austin-lew/Battery_Protector_AN_Hardware/rev1/testing/mosfet_test_b.jpg

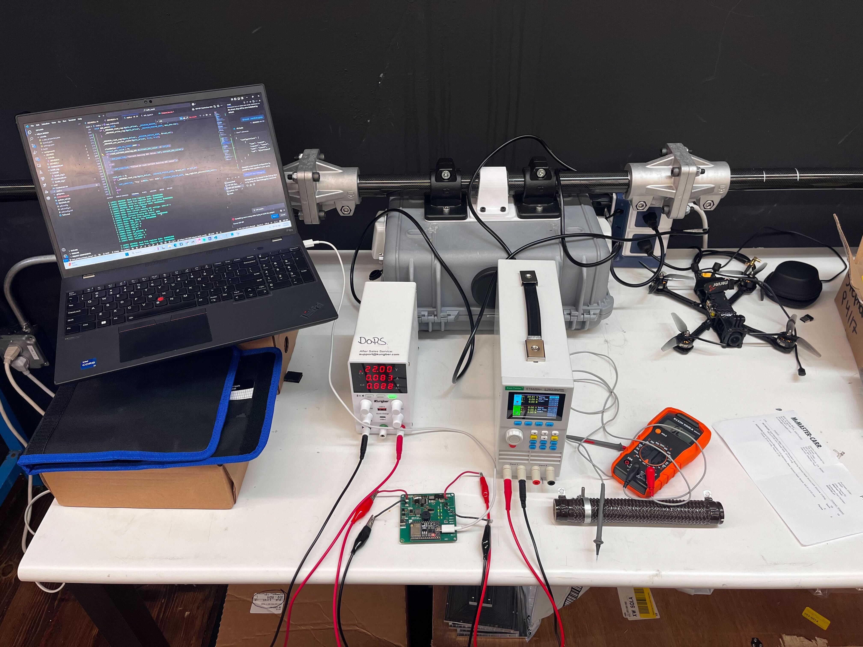
rev1/testing/mosfet_test_b.jpg
