austin-lew/Battery_Protector_AN_Hardware/battery_protector.kicad_pcb

## KiCad design battery_protector.kicad_pcb (2025-08-19)

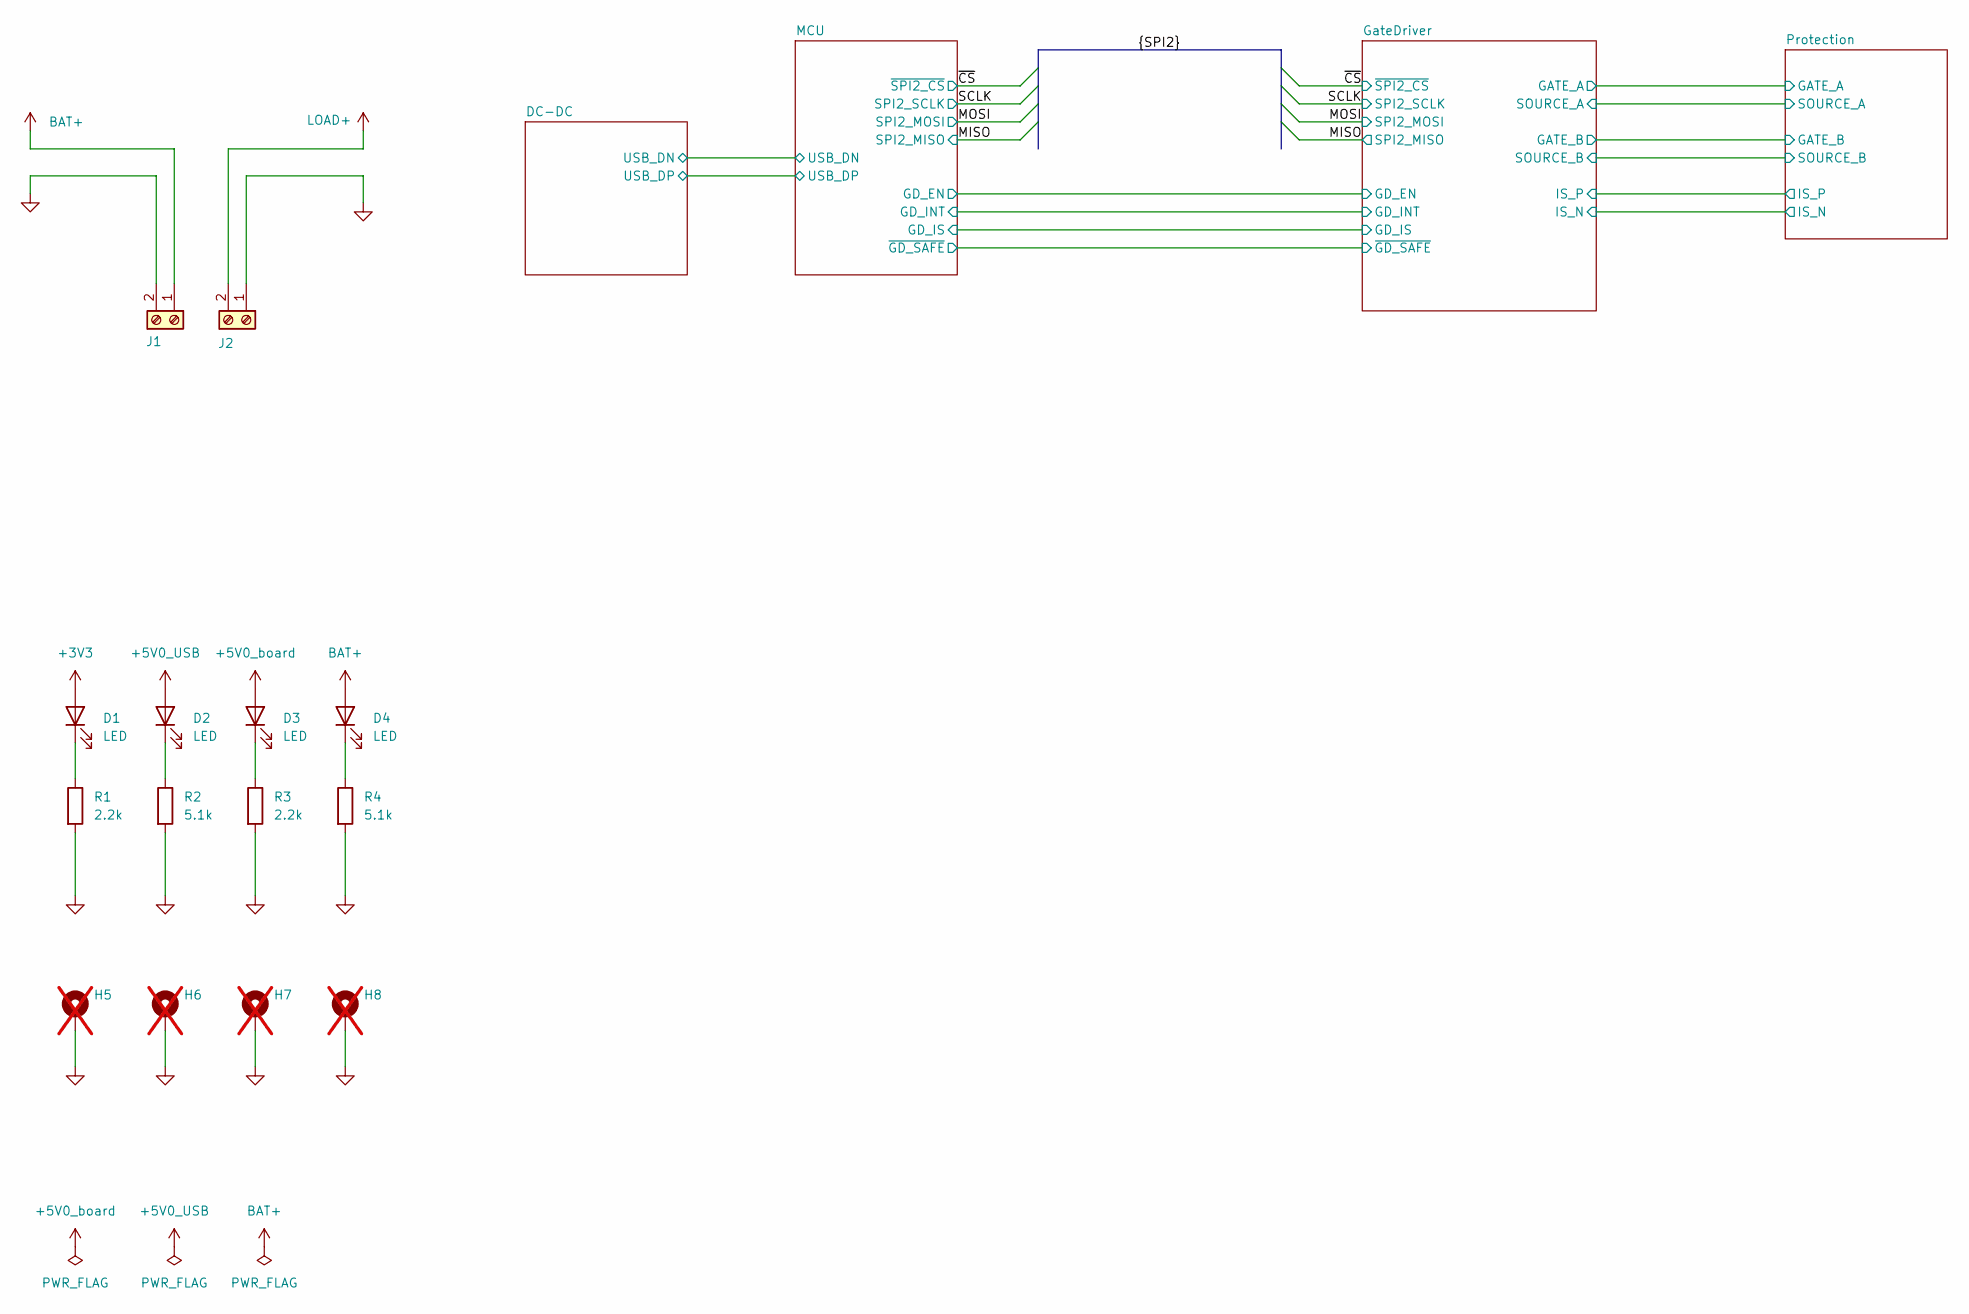
[picture p3: schematic battery_protector.kicad_sch, Top_Level]

Parts:
D1, D2, D3, D4: LED; LED_0603_1608Metric; Manufacturer_Part_Number LTST-C190GKT
H5, H6, H7, H8: MountingHole_Pad; MountingHole_3.2mm_M3_Pad_TopBottom; not fitted
J1, J2: TB005-762-02BE; CUI_TB005-762-02BE; Manufacturer_Part_Number TB005-762-02BE
R1, R3: 2.2k; R_0603_1608Metric; Manufacturer_Part_Number RC0603FR-072K2L
R2, R4: 5.1k; R_0603_1608Metric; Manufacturer_Part_Number RC0603FR-075K1L

Connections:
+3V3: D1.2 (A); also elsewhere on the board
+5V0_USB: D2.2 (A); also elsewhere on the board
+5V0_board: D3.2 (A); also elsewhere on the board
BAT+: D4.2 (A), J1.1; also elsewhere on the board
GND: H5.1, H6.1, H7.1, H8.1, J1.2, J2.1, R1.2, R2.2, R3.2, R4.2; also elsewhere on the board
LOAD+: J2.2; also elsewhere on the board
unnamed: D1.1 (K), R1.1
unnamed: D2.1 (K), R2.1
unnamed: D3.1 (K), R3.1
unnamed: D4.1 (K), R4.1

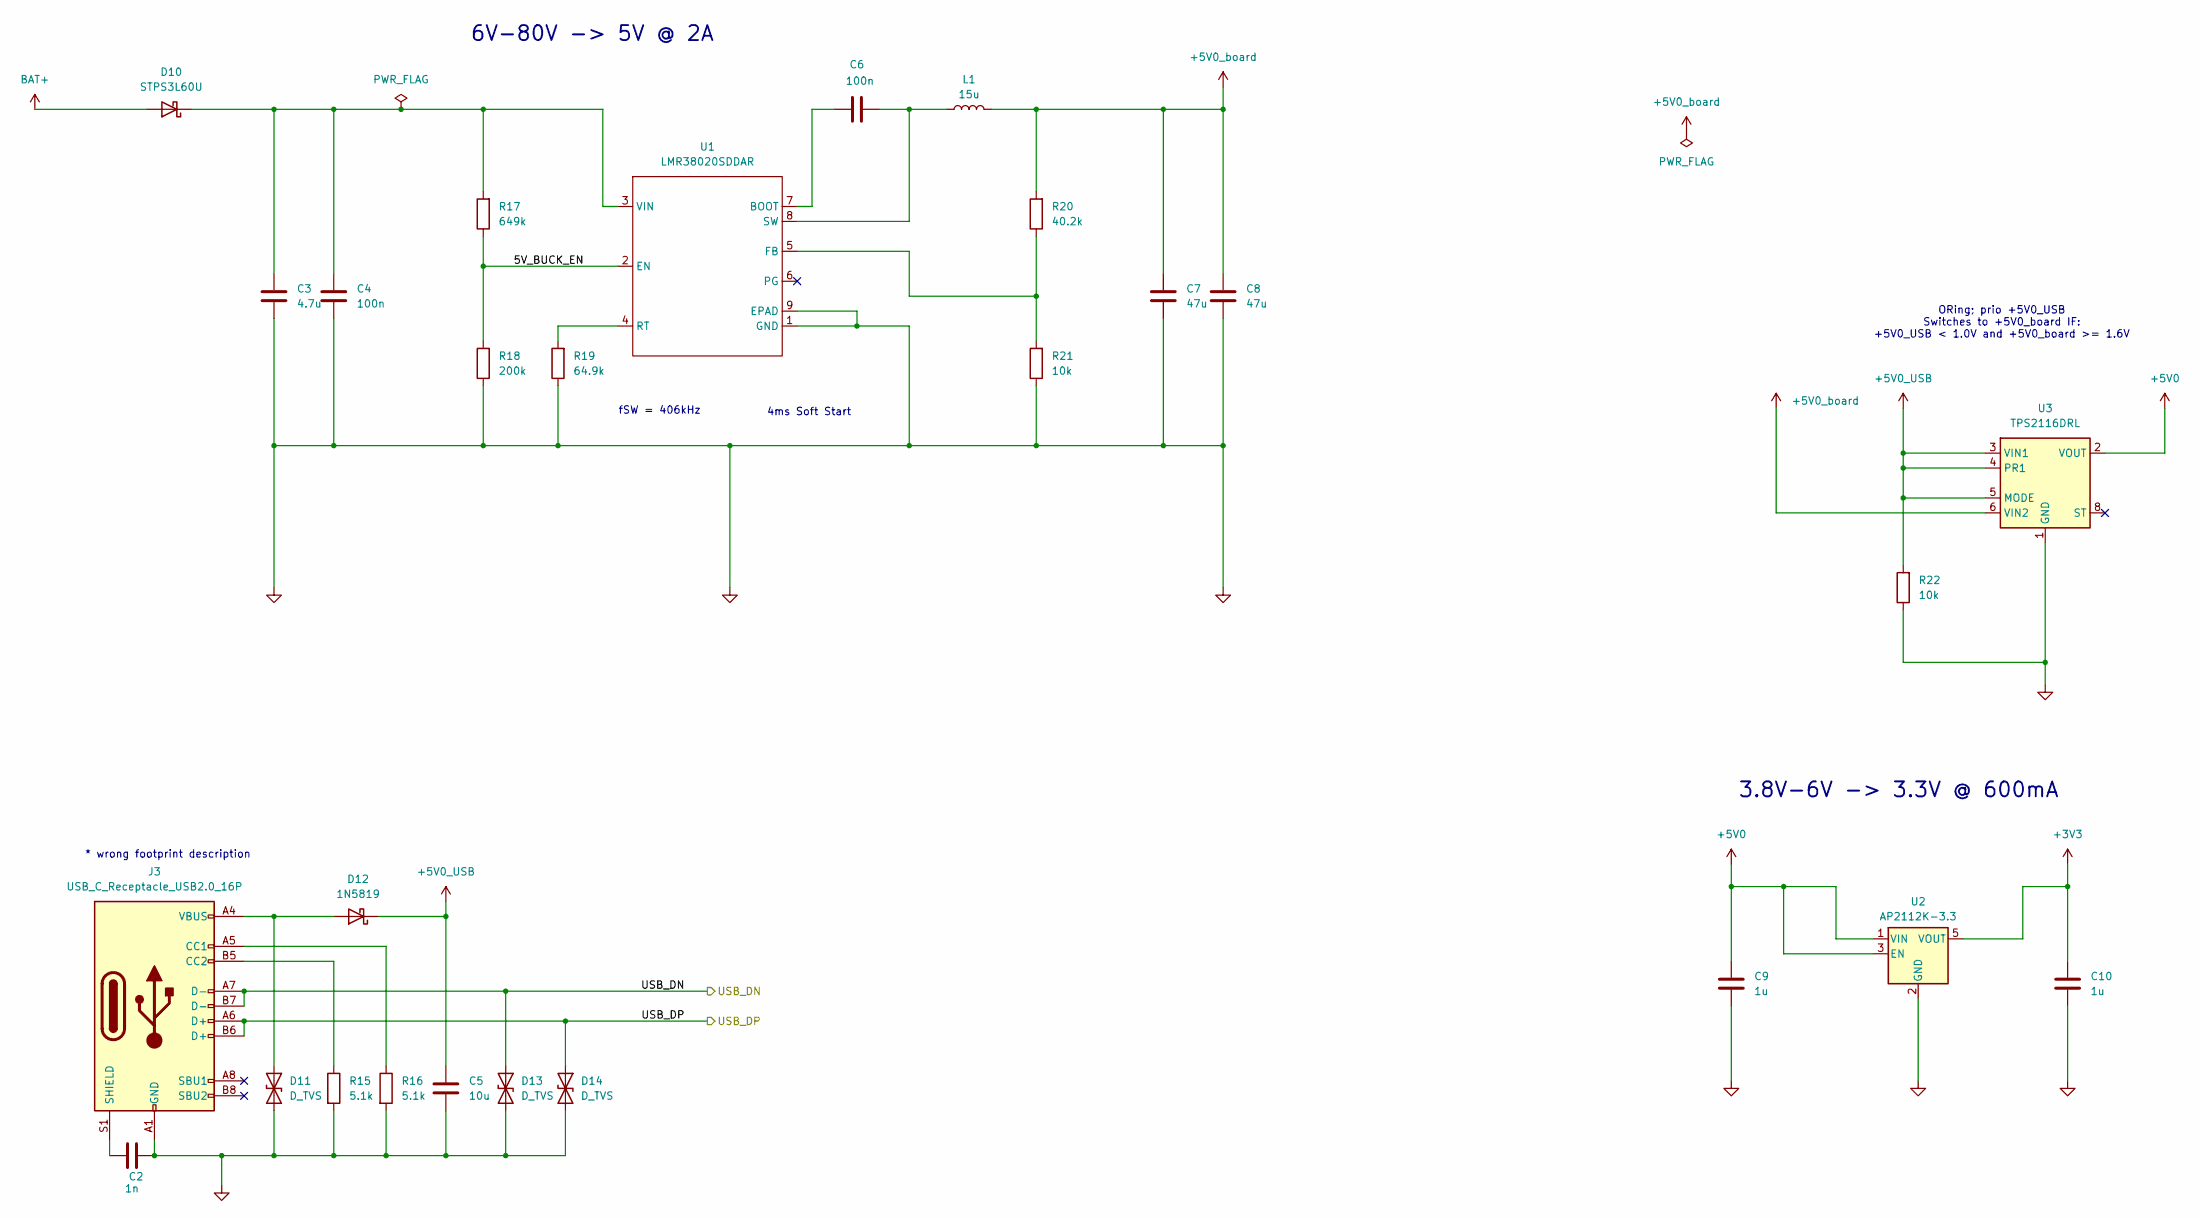
[picture p4: schematic DC-DC.kicad_sch]

Parts:
C2: 1n; C_0603_1608Metric; Manufacturer_Part_Number C0603C102K5RACTU
C3: 4.7u; C_1206_3216Metric; Manufacturer_Part_Number GRM31CC72A475KE11L
C4, C6: 100n; C_0603_1608Metric; Manufacturer_Part_Number CL10B104KC8NNNC
C5: 10u; C_0603_1608Metric; Manufacturer_Part_Number LMK107BBJ106MALT
C7, C8: 47u; C_0603_1608Metric; Manufacturer_Part_Number GRM188R60J476ME15D
C9, C10: 1u; C_0603_1608Metric; Manufacturer_Part_Number TMK107B7105KA-T
D10: STPS3L60U; Manufacturer_Part_Number STPS3L60U
D11, D13, D14: D_TVS; D_0402_1005Metric; Manufacturer_Part_Number D5V0H1B2LP-7B
D12: 1N5819; 1N5819HW-7-F; Manufacturer_Part_Number 1N5819HW-7-F
J3: USB_C_Receptacle_USB2.0_16P; USB_C_Receptacle_GCT_USB4105-xx-A_16P_TopMnt_Horizontal; Manufacturer_Part_Number USB4105-GF-A
L1: 15u; L_Bourns_SRR1208_12.7x12.7mm; Manufacturer_Part_Number SRR1208-150ML
R15, R16: 5.1k; R_0603_1608Metric; Manufacturer_Part_Number RC0603FR-075K1L
R17: 649k; R_0603_1608Metric; Manufacturer_Part_Number RC0603FR-07649KL
R18: 200k; R_0603_1608Metric; Manufacturer_Part_Number RC0603FR-07200KL
R19: 64.9k; R_0603_1608Metric; Manufacturer_Part_Number RC0603FR-0764K9L
R20: 40.2k; R_0603_1608Metric; Manufacturer_Part_Number RC0603FR-1340K2L
R21, R22: 10k; R_0603_1608Metric; Manufacturer_Part_Number RC0603JR-0710KL
U1: LMR38020SDDAR; Texas_R-PDSO-G8_EP2.95x4.9mm_Mask2.4x3.1mm; Manufacturer_Part_Number LMR38020SDDAR
U2: AP2112K-3.3; SOT-23-5; Manufacturer_Part_Number AP2112K-3.3TRG1
U3: TPS2116DRL; SOT-583-8; Manufacturer_Part_Number TPS2116DRLR

Connections:
+3V3: C10.1, U2.5 (VOUT); also elsewhere on the board
+5V0: C9.1, U2.1 (VIN), U2.3 (EN), U3.2 (VOUT), U3.7 (VOUT); also elsewhere on the board
+5V0_USB: C5.2, D12.1 (K), R22.2, U3.3 (VIN1), U3.4 (PR1), U3.5 (MODE); also elsewhere on the board
+5V0_board: C7.1, C8.1, L1.2, R20.2, U3.6 (VIN2); also elsewhere on the board
/DC-DC/5V_BUCK_EN: R17.1, R18.2, U1.2 (EN)
/DC-DC/USB_DN: D13.1 (A1), J3.A7 (D-), J3.B7 (D-); also elsewhere on the board
/DC-DC/USB_DP: D14.1 (A1), J3.A6 (D+), J3.B6 (D+); also elsewhere on the board
BAT+: D10.2 (A); also elsewhere on the board
GND: C2.2, C3.2, C4.2, C5.1, C7.2, C8.2, C9.2, C10.2, D11.2 (A2), D13.2 (A2), D14.2 (A2), J3.A1 (GND), J3.A12 (GND), J3.B1 (GND), J3.B12 (GND), R15.2, R16.2, R18.1, R19.1, R21.1, R22.1, U1.1 (GND), U1.9 (EPAD), U2.2 (GND), U3.1 (GND); also elsewhere on the board
unnamed: C3.1, C4.1, D10.1 (K), R17.2, U1.3 (VIN)
unnamed: D11.1 (A1), D12.2 (A), J3.A4 (VBUS), J3.A9 (VBUS), J3.B4 (VBUS), J3.B9 (VBUS)
unnamed: J3.A5 (CC1), R16.1
unnamed: J3.B5 (CC2), R15.1
unnamed: C2.1, J3.S1 (SHIELD)
unnamed: C6.2, U1.7 (BOOT)
unnamed: R20.1, R21.2, U1.5 (FB)
unnamed: R19.2, U1.4 (RT)
unnamed: C6.1, L1.1, U1.8 (SW)

Notes on the sheet:
3.8V-6V -> 3.3V @ 600mA
ORing; prio +5V0_USB Switches to +5V0_board IF: +5V0_USB < 1.0V and +5V0_board >= 1.6V
fSW = 406kHz
4ms Soft Start
6V-80V -> 5V @ 2A
* wrong footprint description

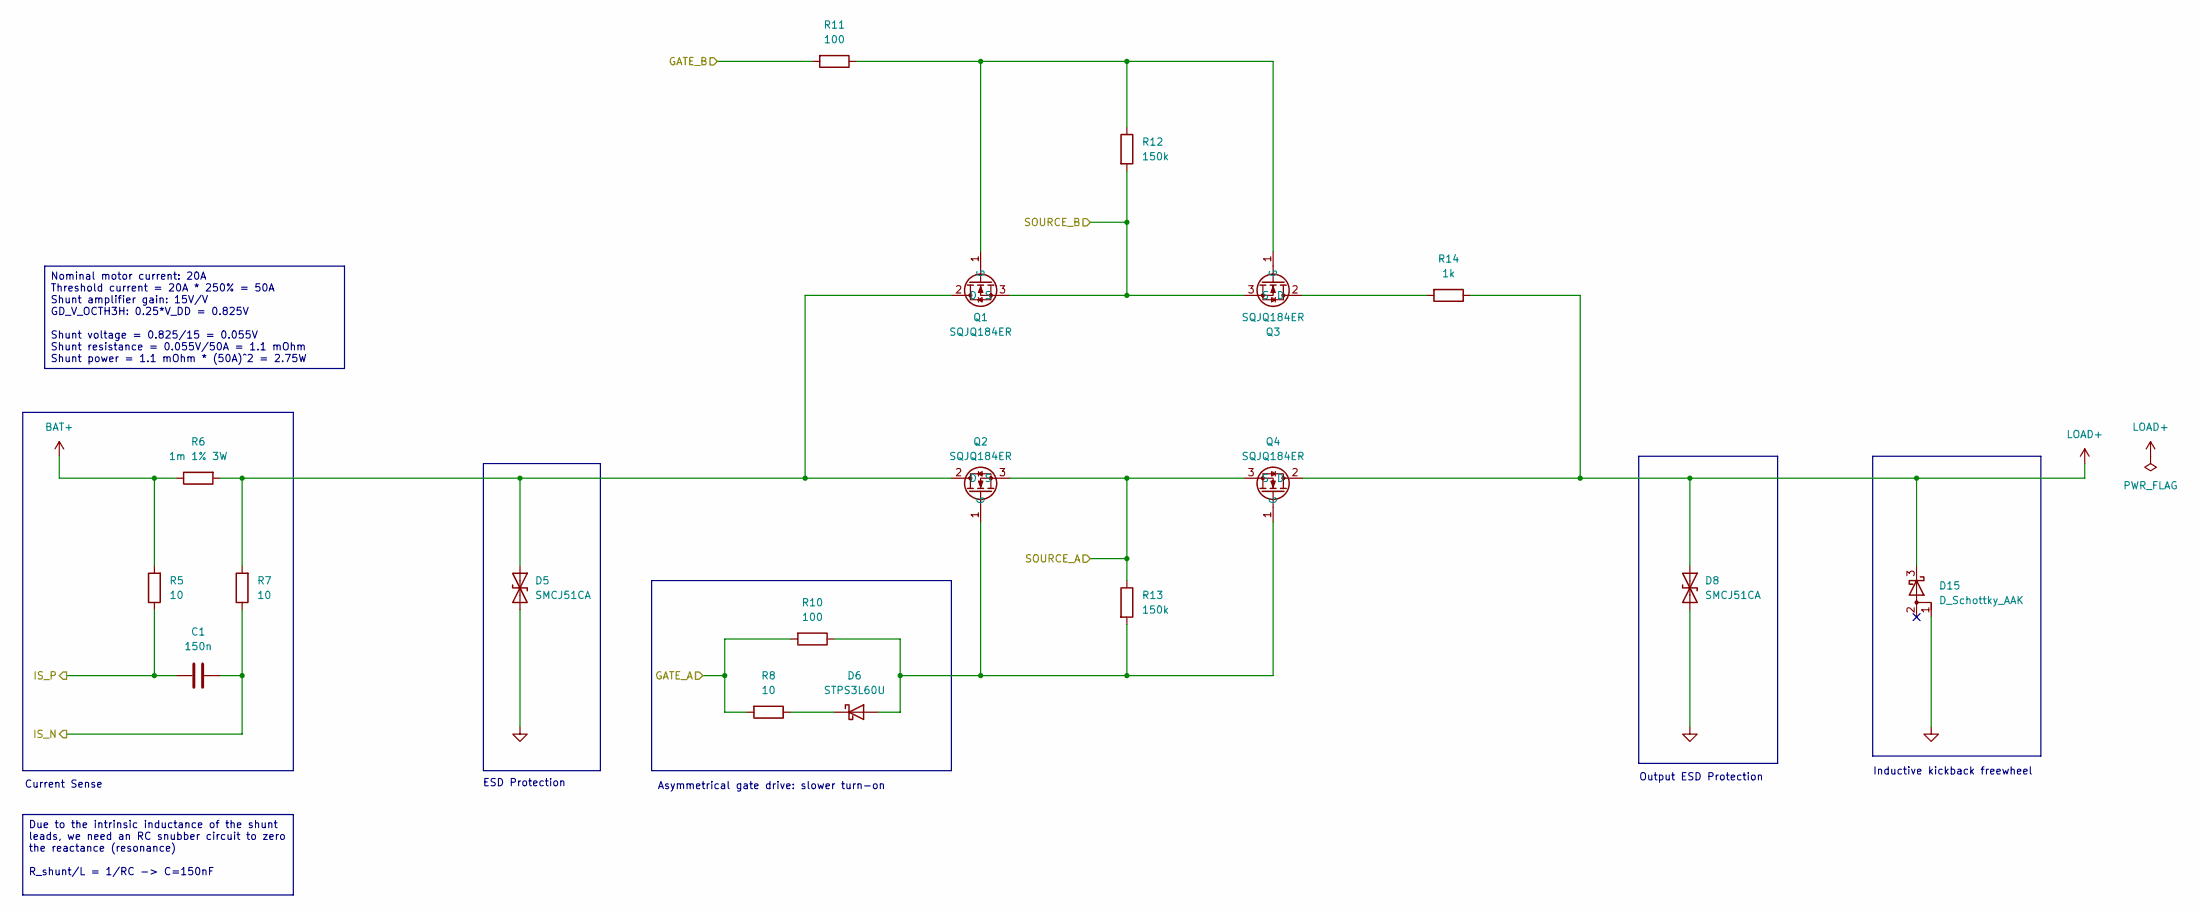
[picture p5: schematic protection.kicad_sch]

Parts:
C1: 150n; C_0603_1608Metric; Manufacturer_Part_Number CL10B154KO8NNNC
D5, D8: SMCJ51CA; D_SMC; Manufacturer_Part_Number SMCJ51CA
D6: STPS3L60U; Manufacturer_Part_Number STPS3L60U
D15: D_Schottky_AAK; VB30100S-E38W; Manufacturer_Part_Number VB30100S-E3/8W
Q1, Q2, Q3, Q4: SQJQ184ER; Manufacturer_Part_Number SQJQ184ER-T1_GE3
R5, R7, R8: 10; R_0603_1608Metric; Manufacturer_Part_Number RC0603FR-0710RL
R6: 1m 1% 3W; WSK12161L000FEA; Manufacturer_Part_Number WSK12161L000FEA
R10, R11: 100; R_0603_1608Metric; Manufacturer_Part_Number RC0603FR-0710RL
R12, R13: 150k; R_0603_1608Metric; Manufacturer_Part_Number AC0603FR-07150KL
R14: 1k; R_1206_3216Metric; Manufacturer_Part_Number HRG3216P-1001-D-T1

Connections:
/GateDriver/GATE_A: R8.2, R10.2; also elsewhere on the board
/GateDriver/GATE_B: R11.2; also elsewhere on the board
/GateDriver/IS_N: C1.1, R7.1; also elsewhere on the board
/GateDriver/IS_P: C1.2, R5.1; also elsewhere on the board
/GateDriver/SOURCE_A: Q2.3 (S), Q4.3 (S), R13.1; also elsewhere on the board
/GateDriver/SOURCE_B: Q1.3 (S), Q3.3 (S), R12.2; also elsewhere on the board
BAT+: R5.2, R6.1; also elsewhere on the board
GND: D5.2 (A2), D8.2 (A2), D15.1 (A); also elsewhere on the board
LOAD+: D8.1 (A1), D15.3 (K), Q4.2 (D), R14.1; also elsewhere on the board
unnamed: D5.1 (A1), Q1.2 (D), Q2.2 (D), R6.2, R7.2
unnamed: D6.2 (A), Q2.1 (G), Q4.1 (G), R10.1, R13.2
unnamed: D6.1 (K), R8.1
unnamed: Q1.1 (G), Q3.1 (G), R11.1, R12.1
unnamed: Q3.2 (D), R14.2

Notes on the sheet:
Output ESD Protection
Asymmetrical gate drive: slower turn-on
Current Sense
Inductive kickback freewheel
ESD Protection
Nominal motor current: 20A Threshold current = 20A * 250% = 50A Shunt amplifier gain: 15V/V GD_V_OCTH3H: 0.25*V_DD = 0.825V Shunt voltage = 0.825/15 = 0.055V Shunt resistance = 0.055V/50A = 1.1 mOhm Shunt power = 1.1 mOhm * (50A)^2 = 2.75W
Due to the intrinsic inductance of the shunt leads, we need an RC snubber circuit to zero the reactance (resonance) R_shunt/L = 1/RC -> C=150nF

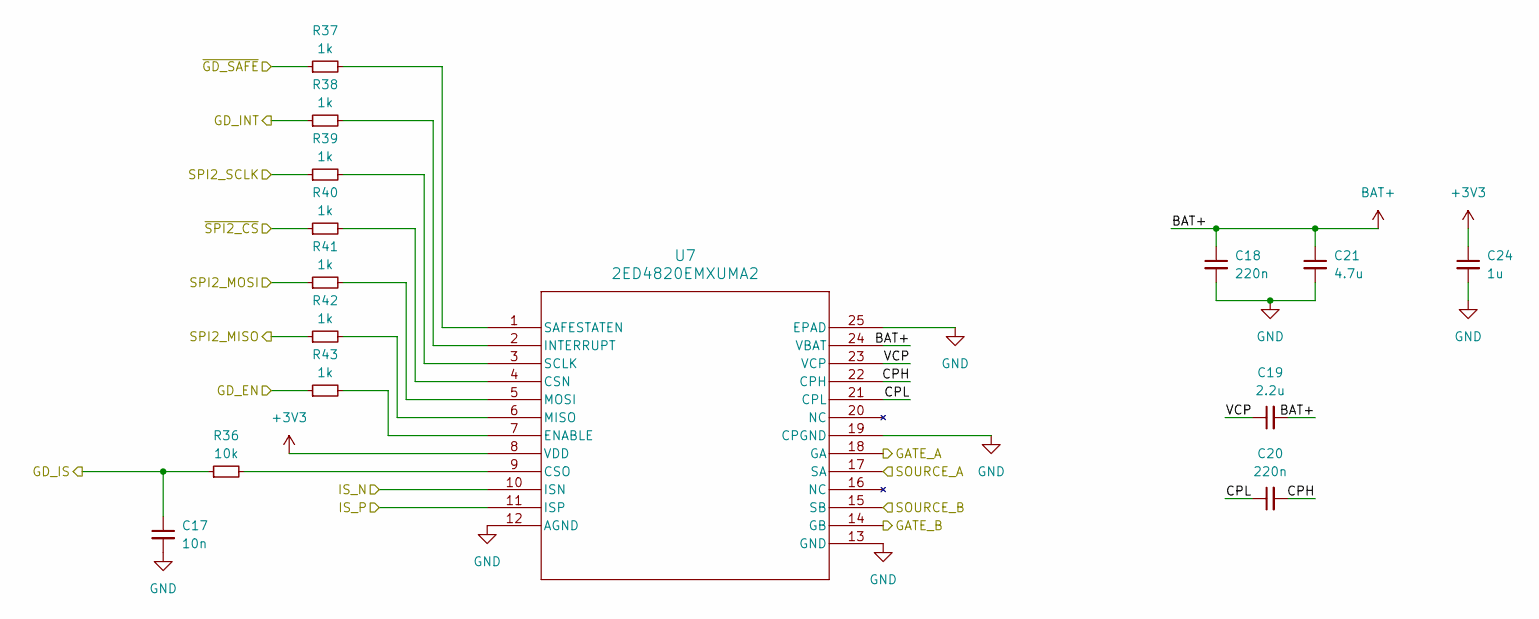
[picture p6: schematic GateDriver.kicad_sch]

Parts:
C17: 10n; C_0603_1608Metric; Manufacturer_Part_Number GCM188R72A103KA37D
C18, C20: 220n; C_1206_3216Metric; Manufacturer_Part_Number C3216X7R2A224K115AA
C19: 2.2u; C_1206_3216Metric; Manufacturer_Part_Number CL31B225KCHSNNE
C21: 4.7u; C_1206_3216Metric; Manufacturer_Part_Number GRM31CC72A475KE11L
C24: 1u; C_0603_1608Metric; Manufacturer_Part_Number TMK107B7105KA-T
R36: 10k; R_0603_1608Metric; Manufacturer_Part_Number RC0603JR-0710KL
R37, R38, R39, R40, R41, R42, R43: 1k; R_0603_1608Metric; Manufacturer_Part_Number RC0603FR-071KL
U7: 2ED4820EMXUMA2; 2ed4820emxuma2; Manufacturer_Part_Number 2ED4820EMXUMA2

Connections:
+3V3: C24.1, U7.8 (VDD); also elsewhere on the board
/GateDriver/CPH: C20.2, U7.22 (CPH)
/GateDriver/CPL: C20.1, U7.21 (CPL)
/GateDriver/GATE_A: U7.18 (GA); also elsewhere on the board
/GateDriver/GATE_B: U7.14 (GB); also elsewhere on the board
/GateDriver/IS_N: U7.10 (ISN); also elsewhere on the board
/GateDriver/IS_P: U7.11 (ISP); also elsewhere on the board
/GateDriver/SOURCE_A: U7.17 (SA); also elsewhere on the board
/GateDriver/SOURCE_B: U7.15 (SB); also elsewhere on the board
/GateDriver/VCP: C19.1, U7.23 (VCP)
/MCU/GD_EN: R43.1; also elsewhere on the board
/MCU/GD_INT: R38.1; also elsewhere on the board
/MCU/GD_IS: C17.1, R36.1; also elsewhere on the board
/MCU/~GD_SAFE: R37.1; also elsewhere on the board
/MISO: R42.1; also elsewhere on the board
/MOSI: R41.1; also elsewhere on the board
/SCLK: R39.1; also elsewhere on the board
/~CS: R40.1; also elsewhere on the board
BAT+: C18.1, C19.2, C21.1, U7.24 (VBAT); also elsewhere on the board
GND: C17.2, C18.2, C21.2, C24.2, U7.12 (AGND), U7.13 (GND), U7.19 (CPGND), U7.25 (EPAD); also elsewhere on the board
unnamed: R40.2, U7.4 (CSN)
unnamed: R36.2, U7.9 (CSO)
unnamed: R43.2, U7.7 (ENABLE)
unnamed: R38.2, U7.2 (INTERRUPT)
unnamed: R42.2, U7.6 (MISO)
unnamed: R41.2, U7.5 (MOSI)
unnamed: R37.2, U7.1 (SAFESTATEN)
unnamed: R39.2, U7.3 (SCLK)

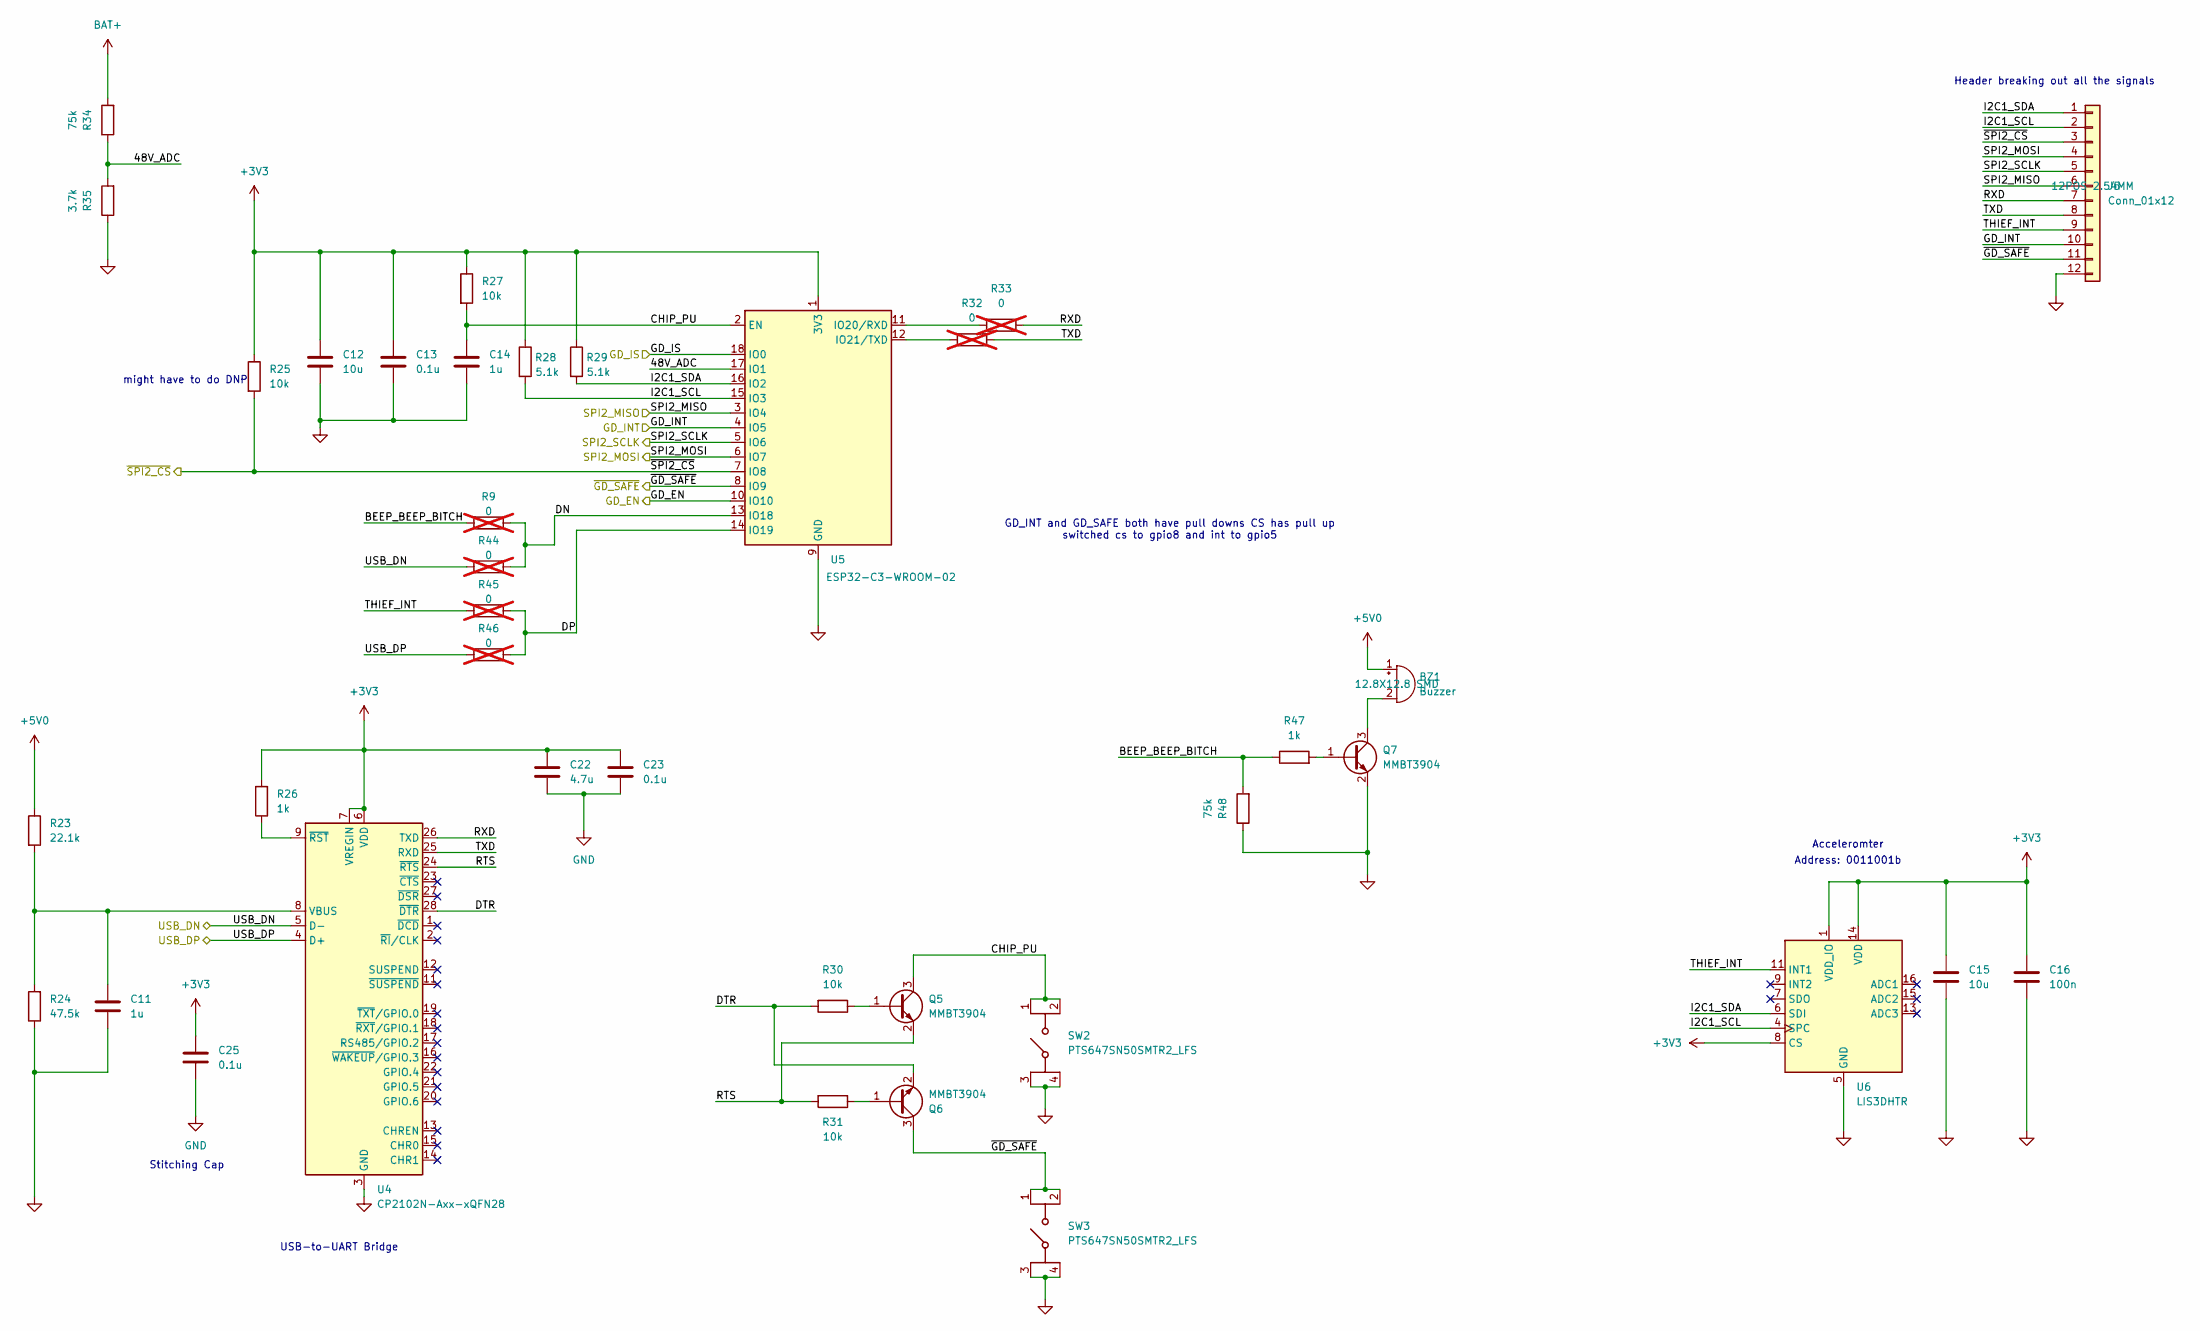
[picture p7: schematic MCU.kicad_sch]

Parts:
BZ1: Buzzer; MagneticBuzzer_CT_1205C_SMT_TR; Manufacturer_Part_Number CT-1205C-SMT-TR
C11, C14: 1u; C_0603_1608Metric; Manufacturer_Part_Number TMK107B7105KA-T
C12, C15: 10u; C_0603_1608Metric; Manufacturer_Part_Number LMK107BBJ106MALT
C13, C23, C25: 0.1u; C_0603_1608Metric; Manufacturer_Part_Number CC0603KRX7R7BB104
C16: 100n; C_0603_1608Metric; Manufacturer_Part_Number CL10B104KC8NNNC
C22: 4.7u; C_0603_1608Metric; Manufacturer_Part_Number CL10A475KP8NNNC
J5: Conn_01x12; PinHeader_1x12_P2.54mm_Vertical; Manufacturer_Part_Number PH1-12-UA
Q5, Q6, Q7: MMBT3904; SOT-23; Manufacturer_Part_Number MMBT3904 RFG
R9, R32, R33, R44, R45, R46: 0; R_0201_0603Metric; not fitted
R23: 22.1k; R_0603_1608Metric; Manufacturer_Part_Number RC0603FR-0722K1L
R24: 47.5k; R_0603_1608Metric; Manufacturer_Part_Number RC0603FR-0747K5L
R25, R27, R30, R31: 10k; R_0603_1608Metric; Manufacturer_Part_Number RC0603JR-0710KL
R26, R47: 1k; R_0603_1608Metric; Manufacturer_Part_Number RC0603FR-071KL
R28, R29: 5.1k; R_0603_1608Metric; Manufacturer_Part_Number RC0603FR-075K1L
R34, R48: 75k; R_0603_1608Metric; Manufacturer_Part_Number AC0603FR-0775KL
R35: 3.7k; R_0603_1608Metric; Manufacturer_Part_Number RN73H1JTTD3701B25
SW2, SW3: PTS647SN50SMTR2_LFS; PTS647SK50SMTR2LFS; Manufacturer_Part_Number PTS647SN50SMTR2 LFS
U4: CP2102N-Axx-xQFN28; QFN-28-1EP_5x5mm_P0.5mm_EP3.35x3.35mm; Manufacturer_Part_Number CP2102N-A02-GQFN28
U5: ESP32-C3-WROOM-02; ESP32-C3-WROOM; Manufacturer_Part_Number ESP32-C3-WROOM-02-H4
U6: LIS3DHTR; LGA-16_3x3mm_P0.5mm_LayoutBorder3x5y_2; Manufacturer_Part_Number LIS3DHTR

Connections:
+3V3: C12.1, C13.1, C15.1, C16.1, C22.1, C23.1, C25.1, R25.1, R26.2, R27.1, R28.1, R29.1, U4.6 (VDD), U4.7 (VREGIN), U5.1 (3V3), U6.1 (VDD_IO), U6.8 (CS), U6.14 (VDD); also elsewhere on the board
+5V0: BZ1.1 (+), R23.1; also elsewhere on the board
/DC-DC/USB_DN: R44.2, U4.5 (D-); also elsewhere on the board
/DC-DC/USB_DP: R46.2, U4.4 (D+); also elsewhere on the board
/MCU/48V_ADC: R34.1, R35.2, U5.17 (IO1)
/MCU/BEEP_BEEP_BITCH: R9.2, R47.1, R48.2
/MCU/CHIP_PU: C14.1, Q5.3 (C), R27.2, SW2.1 (NO_1), SW2.2 (NO_2), U5.2 (EN)
/MCU/DN: R9.1, R44.1, U5.13 (IO18)
/MCU/DP: R45.1, R46.1, U5.14 (IO19)
/MCU/DTR: Q6.2 (E), R30.2, U4.28 (~DTR)
/MCU/GD_EN: U5.10 (IO10); also elsewhere on the board
/MCU/GD_INT: J5.10, U5.4 (IO5); also elsewhere on the board
/MCU/GD_IS: U5.18 (IO0); also elsewhere on the board
/MCU/I2C1_SCL: J5.2, R28.2, U5.15 (IO3), U6.4 (SPC)
/MCU/I2C1_SDA: J5.1, R29.2, U5.16 (IO2), U6.6 (SDI)
/MCU/RTS: Q5.2 (E), R31.2, U4.24 (~RTS)
/MCU/RXD: J5.7, R33.1, U4.26 (TXD)
/MCU/THIEF_INT: J5.9, R45.2, U6.11 (INT1)
/MCU/TXD: J5.8, R32.1, U4.25 (RXD)
/MCU/~GD_SAFE: J5.11, Q6.3 (C), SW3.1 (NO_1), SW3.2 (NO_2), U5.8 (IO9); also elsewhere on the board
/MISO: J5.6, U5.3 (IO4); also elsewhere on the board
/MOSI: J5.4, U5.6 (IO7); also elsewhere on the board
/SCLK: J5.5, U5.5 (IO6); also elsewhere on the board
/~CS: J5.3, R25.2, U5.7 (IO8); also elsewhere on the board
BAT+: R34.2; also elsewhere on the board
GND: C11.2, C12.2, C13.2, C14.2, C15.2, C16.2, C22.2, C23.2, C25.2, J5.12, Q7.2 (E), R24.1, R35.1, R48.1, SW2.3 (COM_1), SW2.4 (COM_2), SW3.3 (COM_1), SW3.4 (COM_2), U4.3 (GND), U4.29 (GND), U5.9 (GND), U5.19 (GND), U6.5 (GND), U6.10 (GND), U6.12 (GND); also elsewhere on the board
unnamed: BZ1.2 (-), Q7.3 (C)
unnamed: Q5.1 (B), R30.1
unnamed: Q6.1 (B), R31.1
unnamed: Q7.1 (B), R47.2
unnamed: C11.1, R23.2, R24.2, U4.8 (VBUS)
unnamed: R26.1, U4.9 (~RST)
unnamed: R33.2, U5.11 (IO20/RXD)
unnamed: R32.2, U5.12 (IO21/TXD)

Notes on the sheet:
Acceleromter
might have to do DNP
Address: 0011001b
GD_INT and GD_SAFE both have pull downs CS has pull up switched cs to gpio8 and int to gpio5
Stitching Cap
USB-to-UART Bridge
Header breaking out all the signals

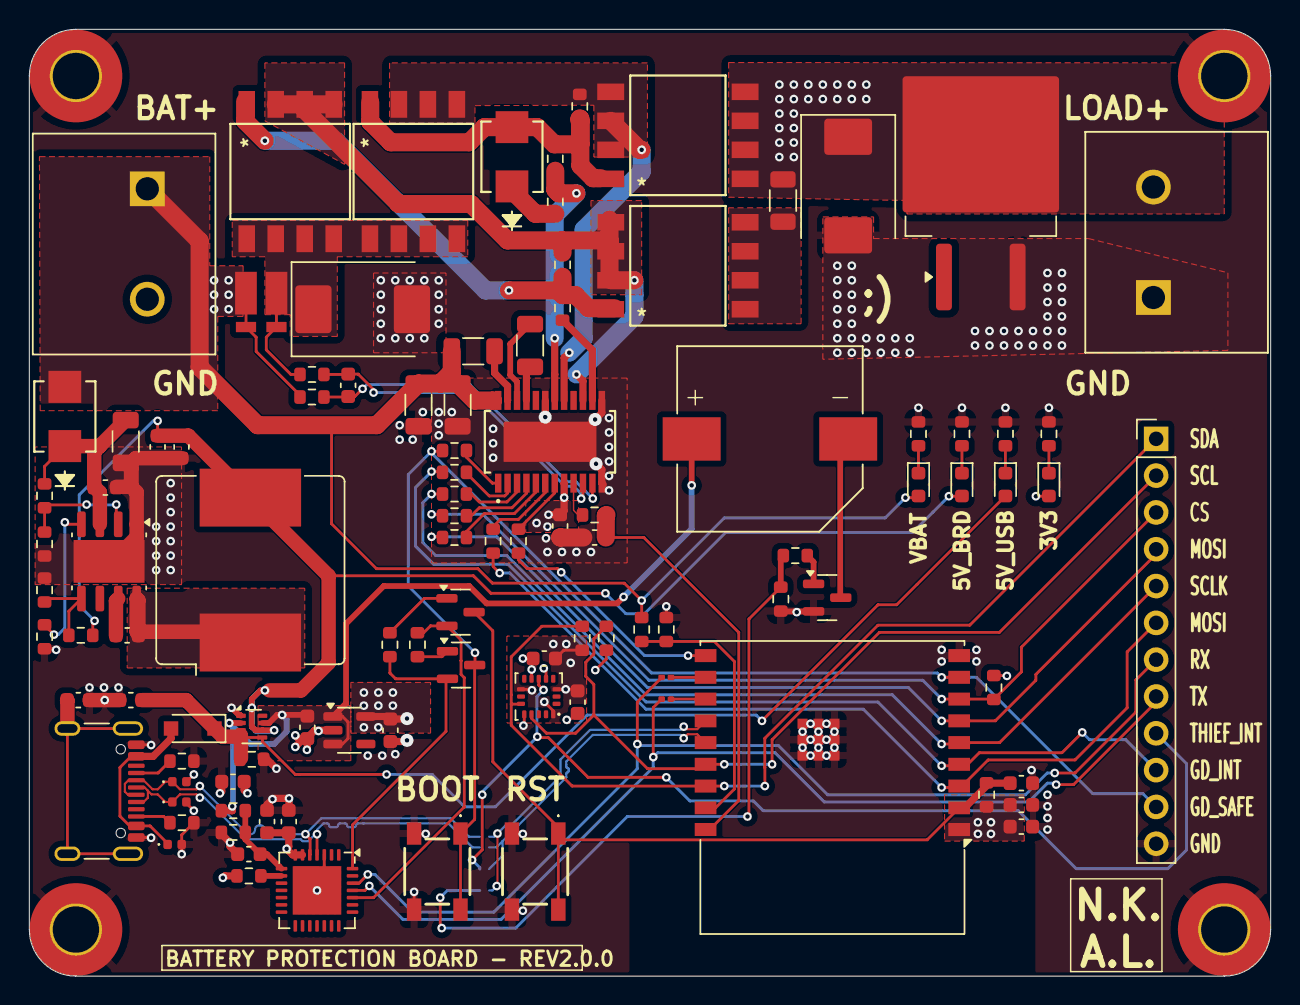
[picture p8: board battery_protector.kicad_pcb from above]

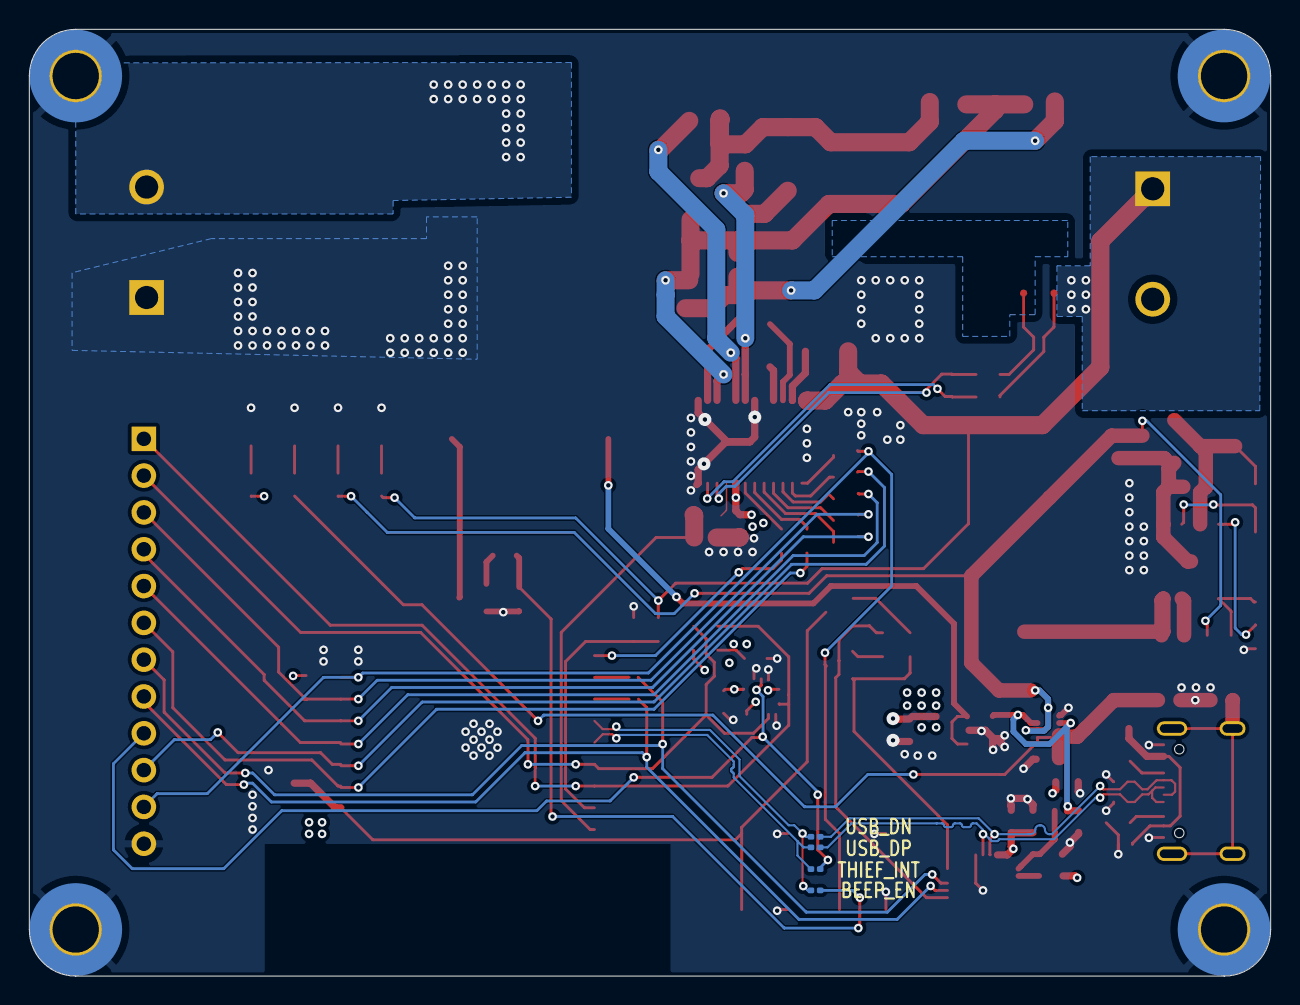
[picture p9: board battery_protector.kicad_pcb from below]

Board: 4 copper layers, 85.7 x 65.3 mm, 112 parts (4 on the bottom side), 73 nets.
