austin-lew/Battery_Protector_AN_Hardware/(commit log)

2025-03-28 setup project skeleton
    [battery_protector.kicad_pcb, battery_protector.kicad_sch]
2025-05-15 Add gate driver (#1)
    * Addded new sheets for Protection, usb-pd, mcu, gatedriver, and dc-dc
    * add gate driver
    ---------
    [DC-DC.kicad_sch, GateDriver.kicad_sch, MCU.kicad_sch, USB_PD.kicad_sch, battery_protector.kicad_sch, protection.kicad_sch]
2025-06-26 Worked on the MCU page and the DC-DC page. Will still need to change a few things and add the buzzer and piezo stuff (#3)
    [DC-DC.kicad_sch, MCU.kicad_sch, USB_PD.kicad_sch, protection.kicad_sch]
2025-07-02 finish protection sheet
    [DC-DC.kicad_sch, GateDriver.kicad_sch, MCU.kicad_sch, USB_PD.kicad_sch, battery_protector.kicad_sch, protection.kicad_sch]
2025-07-06 jul 2 design review
    [MCU.kicad_sch, USB_PD.kicad_sch, protection.kicad_sch]
2025-07-10 Added footprints to resistors and capacitors, and fixed the mosfets wiring issue (#4)
    Jul9th push. Added footprints to resistors and capacitors, and fixed the mosfets wiring issue
    [DC-DC.kicad_sch, GateDriver.kicad_sch, MCU.kicad_sch, battery_protector.kicad_sch, protection.kicad_sch]
2025-07-20 finish schematic
    [DC-DC.kicad_sch, GateDriver.kicad_sch, MCU.kicad_sch, battery_protector.kicad_pcb, battery_protector.kicad_sch, protection.kicad_sch]
2025-07-20 setup layout rules
    [MCU.kicad_sch, battery_protector.kicad_pcb, battery_protector.kicad_sch, protection.kicad_sch]
2025-07-27 first pass layout
    [GateDriver.kicad_sch, MCU.kicad_sch, battery_protector.kicad_pcb]
2025-07-28 Updated pcb rules and started the rough routing of protection circuitry (#5)
    [battery_protector.kicad_pcb, protection.kicad_sch]
2025-08-11 Nima/changes aug 11 (#6)
    * Updated pcb rules and started the rough routing of protection circuitry
    * Did some more routing
    [DC-DC.kicad_sch, GateDriver.kicad_sch, MCU.kicad_sch, battery_protector.kicad_pcb, battery_protector.kicad_sch]
2025-08-12 route dc-dc
    [MCU.kicad_sch, battery_protector.kicad_pcb]
2025-08-15 Routed Gate Driver, will have to move all components to top layer for simplicity and move the switching reg farther away from the mcu
    [battery_protector.kicad_pcb]
2025-08-16 More routing, changed the footprints of some caps.
    [DC-DC.kicad_sch, GateDriver.kicad_sch, MCU.kicad_sch, battery_protector.kicad_pcb, protection.kicad_sch]
2025-08-17 Finished Routing and ran DRC. Will need final review of schematics and layout with Austin. Will also need to update BOM.
    [DC-DC.kicad_sch, MCU.kicad_sch, battery_protector.kicad_pcb]
2025-08-17 add manufacturer, mpn, and package to bom
    [DC-DC.kicad_sch, GateDriver.kicad_sch, MCU.kicad_sch, battery_protector.kicad_sch, protection.kicad_sch]
2025-08-19 Caught some issues and made final changes for manufacturing (#9)
    Caught some issues and made final changes for manufacturing including correcting the imu and J2 footprints, updating the clearance rules we imported from pcbway (.09mm->0.1mm), and the addition of stitching capacitors for usb signal.
    [MCU.kicad_sch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]
2025-09-01 create new .pos file with fixed footprints
